empeeby/feedback-pedal/enclosure-drill-guide.pdf

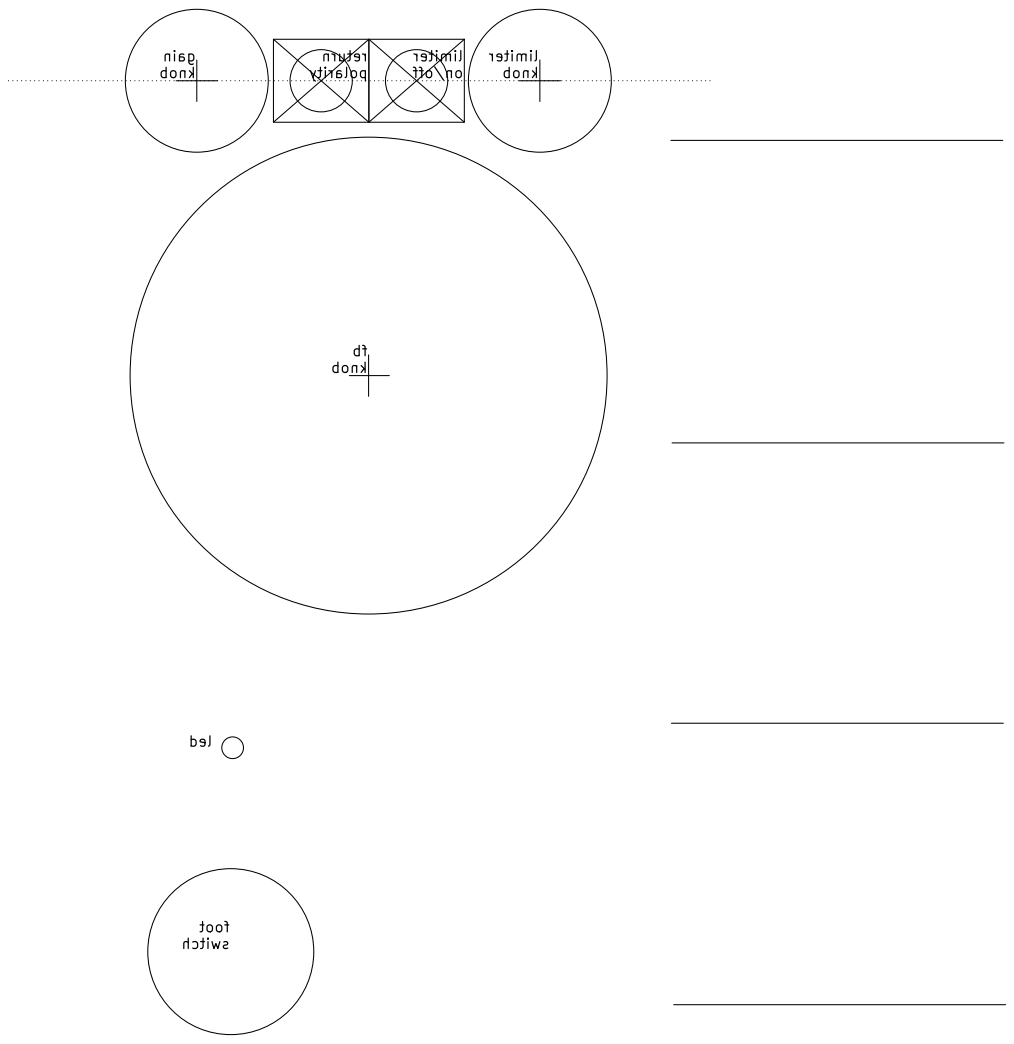
[picture p1: page 1]

limiter on/off return
