empeeby/feedback-pedal/feedbackPedal.kicad_pcb

## KiCad design feedbackPedal.kicad_pcb (2025-10-26)

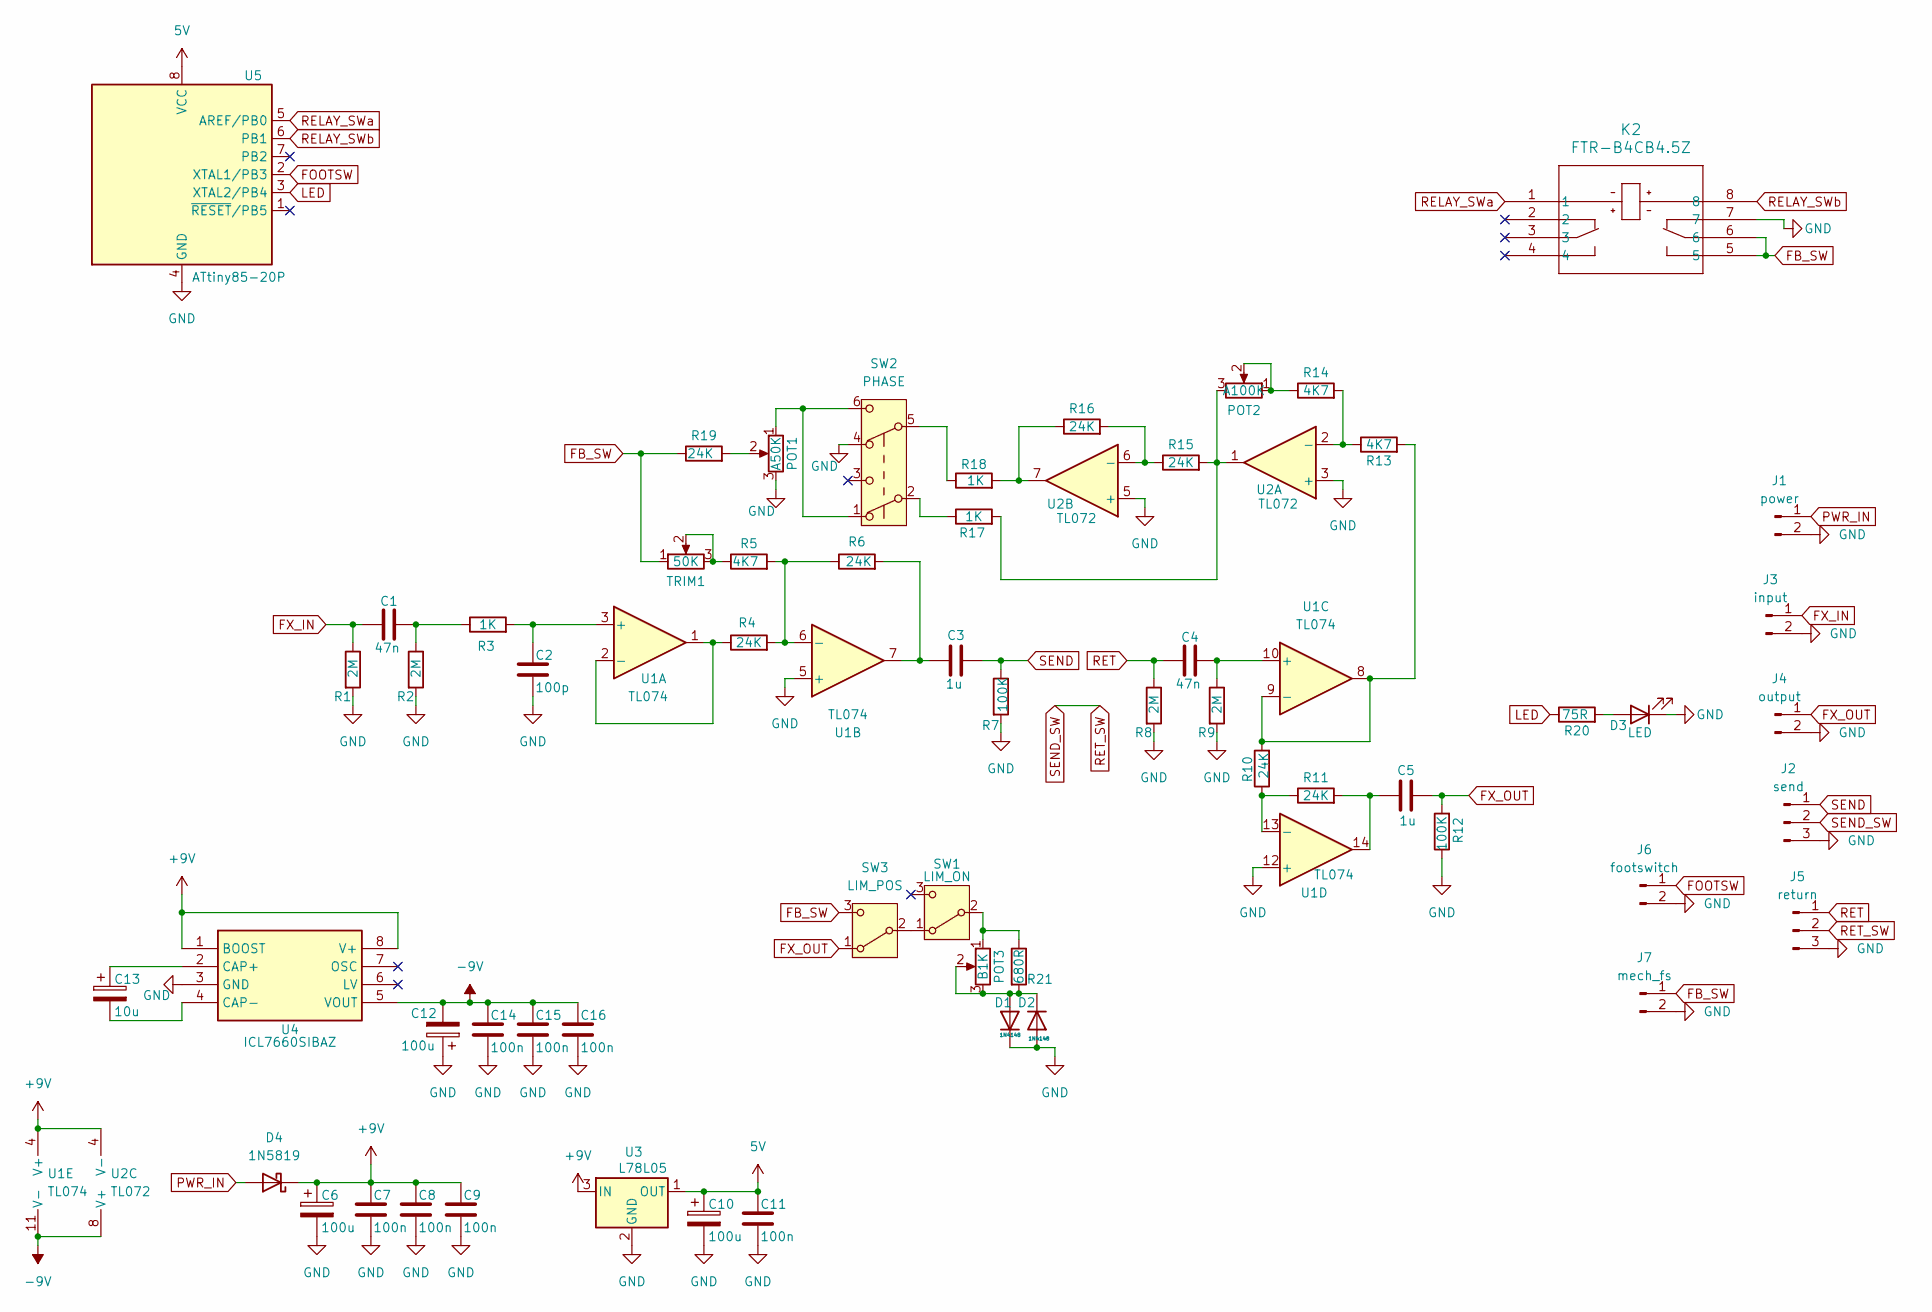
[picture p2: schematic feedbackPedal.kicad_sch]

Parts:
C1, C4: 47n; C_0603_1608Metric
C2: 100p; C_0603_1608Metric
C3, C5: 1u; C_0603_1608Metric
C6, C10, C12: 100u; CP_Elec_5x5.4
C7, C8, C9, C11, C14, C15, C16: 100n; C_0603_1608Metric
C13: 10u; CP_Elec_5x5.4
D1, D2: 1N4148; D_SOD-123
D3: LED; LED_D3.0mm
D4: 1N5819; D_SOD-323
J1: power; PinHeader_1x02_P2.54mm_Vertical
J2: send; PinHeader_1x03_P2.54mm_Vertical
J3: input; PinHeader_1x02_P2.54mm_Vertical
J4: output; PinHeader_1x02_P2.54mm_Vertical
J5: return; PinHeader_1x03_P2.54mm_Vertical
J6: footswitch; PinHeader_1x02_P2.54mm_Vertical
J7: mech_fs; PinHeader_1x02_P2.54mm_Vertical
K2: FTR-B4CB4.5Z; FTR-B4C_FUJ
POT1: A50K; Potentiometer_Alpha_RD901F-40-00D_Single_Vertical_CENTREMARK
POT2: A100K; Potentiometer_Alpha_RD901F-40-00D_Single_Vertical_CENTREMARK
POT3: B1K; Potentiometer_Alpha_RD901F-40-00D_Single_Vertical_CENTREMARK
R1, R2, R8, R9: 2M; R_0603_1608Metric
R3, R17, R18: 1K; R_0603_1608Metric
R4, R6, R10, R11, R15, R16, R19: 24K; R_0603_1608Metric
R5, R13, R14: 4K7; R_0603_1608Metric
R7, R12: 100K; R_0603_1608Metric
R20: 75R; R_0603_1608Metric
R21: 680R; R_Axial_DIN0204_L3.6mm_D1.6mm_P5.08mm_Horizontal
SW1: LIM_ON; 2MS1T1-M2_DYW
SW2: PHASE; 2MD1T1B1M2QES-5
SW3: LIM_POS; SS-12D10G5_XKB
TRIM1: 50K; Potentiometer_Bourns_3296W_Vertical
U1: TL074; SOIC-14_3.9x8.7mm_P1.27mm
U2: TL072; SOIC-8_3.9x4.9mm_P1.27mm
U3: L78L05; SOT-89-3
U4: ICL7660SIBAZ; SOIC-8_3.9x4.9mm_P1.27mm; Mouser Part Number 968-ICL7660SIBAZ
U5: ATtiny85-20P; DIP-8_W7.62mm

Connections:
5V: C10.1, C11.1, U3.1 (OUT), U5.8 (VCC)
+9V: C6.1, C7.1, C8.1, C9.1, D4.1 (K), U1.4 (V+), U2.4 (V-), U3.3 (IN), U4.1 (BOOST), U4.8 (V+)
-9V: C12.2, C14.1, C15.1, C16.1, U1.11 (V-), U2.8 (V+), U4.5 (VOUT)
FB_SW: J7.1, K2.5, K2.6, R19.1, SW3.3 (C), TRIM1.1
FOOTSW: J6.1, U5.2 (XTAL1/PB3)
FX_IN: C1.1, J3.1, R1.1
FX_OUT: C5.2, J4.1, R12.2, SW3.1 (A)
GND: C2.2, C6.2, C7.2, C8.2, C9.2, C10.2, C11.2, C12.1, C14.2, C15.2, C16.2, D1.1 (K), D2.2 (A), D3.1 (K), J1.2, J2.3, J3.2, J4.2, J5.3, J6.2, J7.2, K2.7, POT1.3, R1.2, R2.2, R7.2, R8.2, R9.2, R12.1, SW2.4 (A), U1.5 (+), U1.12 (+), U2.3 (+), U2.5 (+), U3.2 (GND), U4.3 (GND), U5.4 (GND)
LED: R20.1, U5.3 (XTAL2/PB4)
unnamed: C1.2, R2.1, R3.1
unnamed: C3.1, R6.2, U1.7
unnamed: C5.1, R11.2, U1.14
unnamed: D1.2 (A), D2.1 (K), POT3.2, POT3.3, R21.2
unnamed: D3.2 (A), R20.2
unnamed: POT1.1, SW2.1 (A), SW2.6 (C)
unnamed: POT1.2, R19.2
unnamed: POT2.1, POT2.2, R14.1
unnamed: POT2.3, R15.2, R17.2, U2.1
unnamed: R5.1, TRIM1.2, TRIM1.3
unnamed: R16.1, R18.2, U2.7
unnamed: R17.1, SW2.2 (B)
unnamed: R18.1, SW2.5 (B)
unnamed: SW1.1 (A), SW3.2 (B)
unnamed: POT3.1, R21.1, SW1.2 (B)
unnamed: C2.1, R3.2, U1.3 (+)
unnamed: R4.1, U1.1, U1.2 (-)
unnamed: R4.2, R5.2, R6.1, U1.6 (-)
unnamed: C4.2, R9.1, U1.10 (+)
unnamed: R10.2, R13.2, U1.8, U1.9 (-)
unnamed: R10.1, R11.1, U1.13 (-)
unnamed: R13.1, R14.2, U2.2 (-)
unnamed: R15.1, R16.2, U2.6 (-)
unnamed: C13.1, U4.2 (CAP+)
unnamed: C13.2, U4.4 (CAP-)
PWR_IN: D4.2 (A), J1.1
RELAY_SWa: K2.1, U5.5 (AREF/PB0)
RELAY_SWb: K2.8, U5.6 (PB1)
RET: C4.1, J5.1, R8.1
RET_SW: J2.2, J5.2
SEND: C3.2, J2.1, R7.1

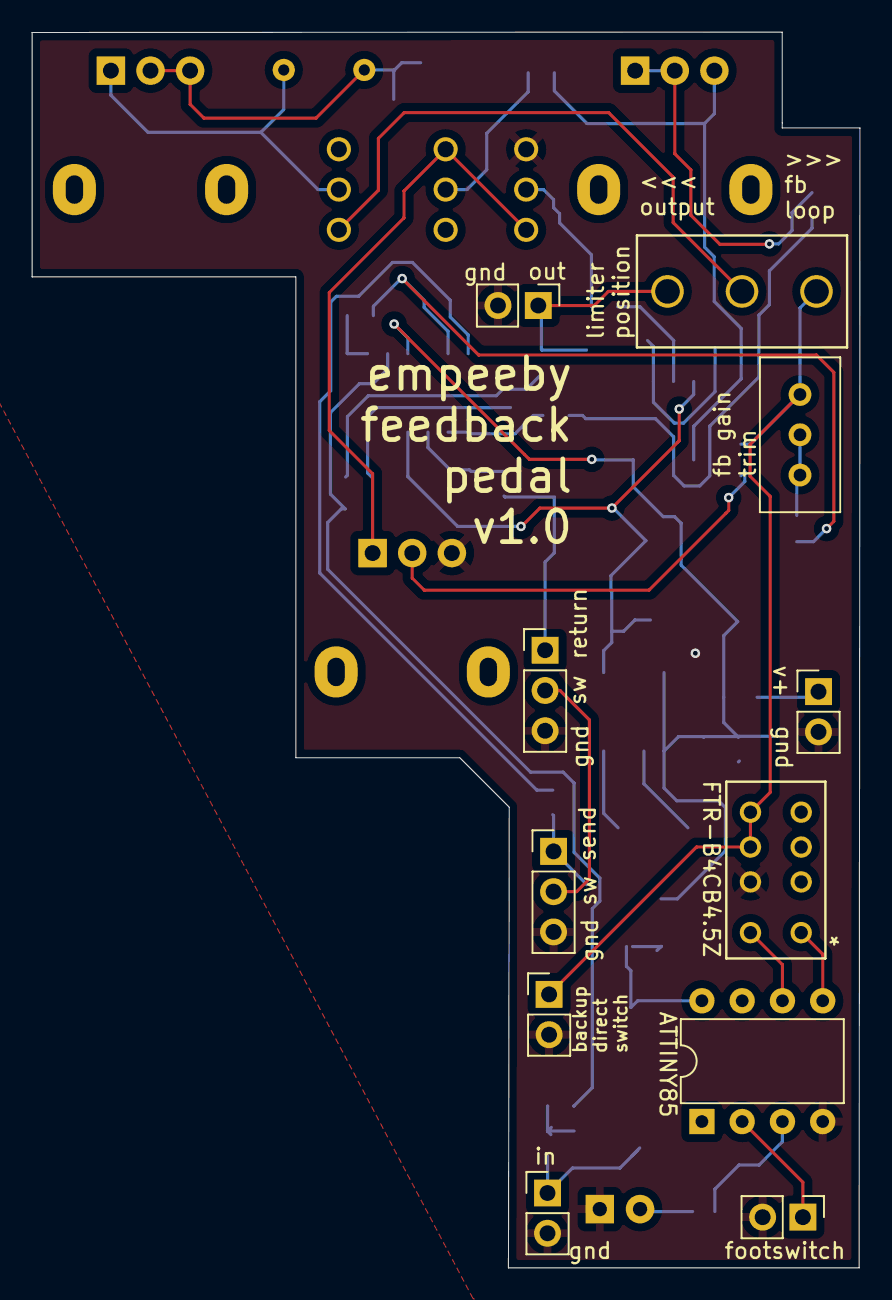
[picture p3: board feedbackPedal.kicad_pcb from above]

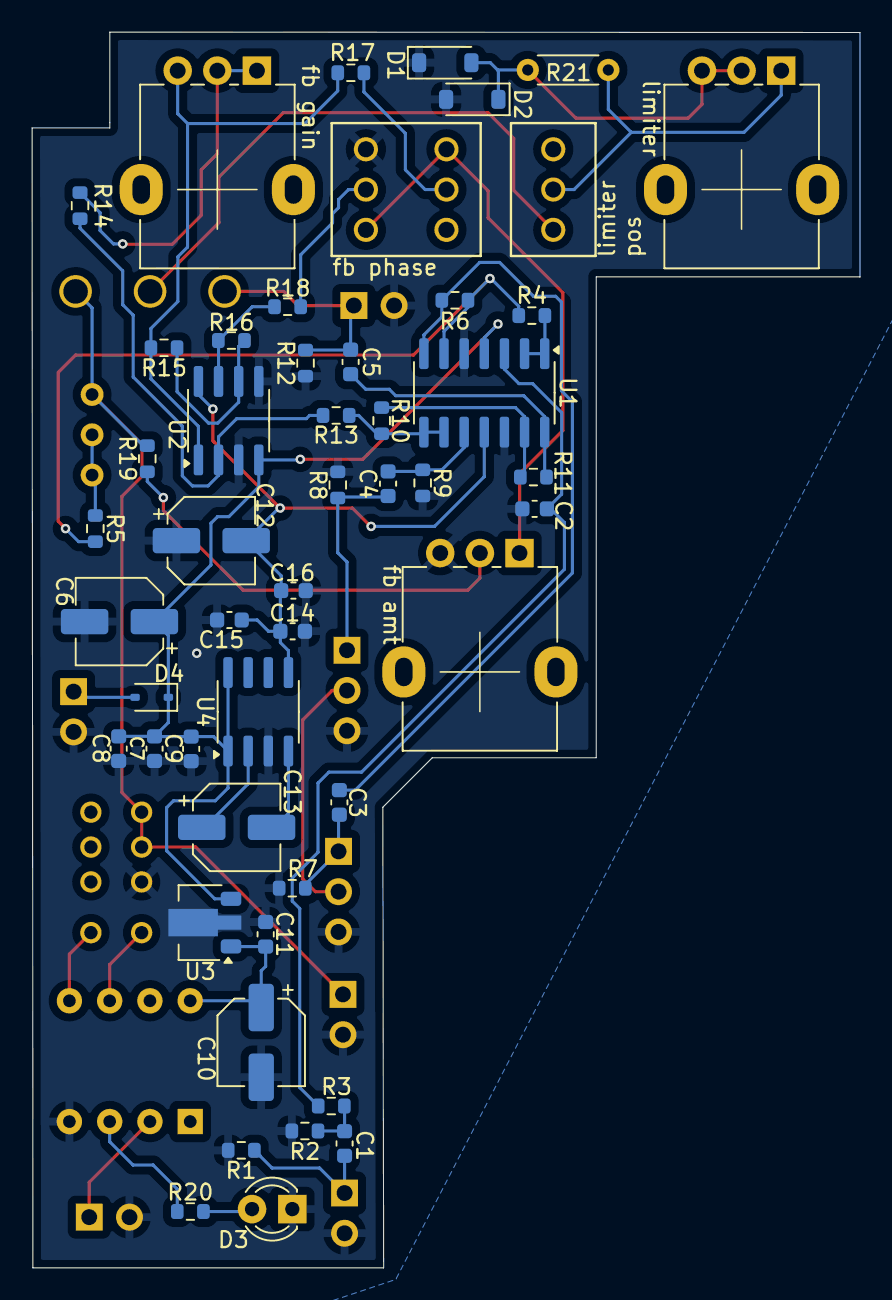
[picture p4: board feedbackPedal.kicad_pcb from below]

Board: 2 copper layers, 52.2 x 78.0 mm, 61 parts (50 on the bottom side), 40 nets.
