empeeby/feedback-pedal/(commit log)

2025-10-26 init repo (first version already done)
    [feedbackPedal-B_Cu.gbl, feedbackPedal-B_Mask.gbs, feedbackPedal-B_Paste.gbp, feedbackPedal-B_Silkscreen.gbo, feedbackPedal-Edge_Cuts.gm1, feedbackPedal-F_Cu.gtl, feedbackPedal-F_Mask.gts, feedbackPedal-F_Paste.gtp]
2026-04-06 made some attiny tweaks
    [feedbackPedal.kicad_sch]
2026-05-29 create rough drill guide
2026-05-29 replace attiny & relay with ch32 and analogue switch
    [feedbackPedal.kicad_sch]
2026-05-29 clear out autorecovered doc
    [feedbackPedalBOM_2024-11-14_edited(AutoRecovered).csv]
